Waller-Lab/CompCellScopeAndroid/README.md

# CompCellScopeAndroid
Computational CellScope Android Application from https://journals.plos.org/plosone/article?id=10.1371/journal.pone.0124938
