Waller-Lab/CompCellScopeAndroid/PCB Designs/Eagle/DomeSlice/README - File Descriptions.txt

CompCellScope PCB Design Files
Zack Phillips, UC Berkeley
zkphil@berkeley.edu

Last Modified 2/23/15

The included files are licensed under the BSD Open Source License, as described in the LICENSE.txt file.

These files were created in EAGLE(R) 6.6.0.

This PCB design was used to attach all LEDs to their controllers, facilitating easy soldering by hand. The boards were chained together to provide serial communication across all LEDs. These boards use TLC5926 LED Controller Chips (Texas Instruments) for LED Control. See the Assembly Instructions file for an assembly overview. Our design used 9 identical boards of this design.

--- File List ---
Slice_v1.1.brd   :   EAGLECAD PCB Layout used for controlling the domed LED Array.
Slice_v1.1.sch   :   Schematic for above file
Slice_v1.1.lbr   :   EAGLE Library containing layouts for all parts used in this design
Slice_v1.1.zip   :   Archive of GERBER Files as sent to PCB fabrication house
