Waller-Lab/CompCellScopeAndroid/PCB Designs/Eagle/PowerBoard/README - File Descriptions.txt

CompCellScope Power Board PCB Design Files
Zack Phillips, UC Berkeley
zkphil@berkeley.edu

Last Modified 2/23/15

The included files are licensed under the BSD Open Source License, as described in the LICENSE.txt file.

These files were created in EAGLE(R) 6.6.0.

This PCB design was used to distribute power to each of the 9 LED Controller boards, as well as the arduino. As an input it takes a TDK-Lambda DT150PW120C 120V AC Adaptor, but can accept any 12V power source given slight modification as described in the Assembly Overview file. This device could be improved by adding heatsinks to the 5V regulators, but works as designed for all intended applications.

--- File List ---
MPB_v1.brd    :   EAGLECAD PCB Layout of Power distribution board
MPB_v1.sch    :   Schematic for above file
MPB_v1.lbr    :   EAGLE Library containing layouts for all parts used in this design
MPB_v1.zip    :   Archive of GERBER Files as sent to PCB fabrication house
