Waller-Lab/CompCellScopeAndroid/CAD Designs/MATLAB/channelMap.xlsx

hole | channel
1 | 320
2 | 257
3 | 256
4 | 200
5 | 384
6 | 392
7 | 321
8 | 328
9 | 264
10 | 193
11 | 201
12 | 136
13 | 128
14 | 456
15 | 386
16 | 393
17 | 322
18 | 329
19 | 258
20 | 265
21 | 203
22 | 192
23 | 137
24 | 130
25 | 73
26 | 457
27 | 387
28 | 385
29 | 394
30 | 330
31 | 259
32 | 266
33 | 195
34 | 202
35 | 138
36 | 131
37 | 129
38 | 74
39 | 449
40 | 451
41 | 515
42 | 395
43 | 396
44 | 323
45 | 331
46 | 267
47 | 268
48 | 204
49 | 194
50 | 141
51 | 132
52 | 75
53 | 68
54 | 64
55 | 518
56 | 523
57 | 460
58 | 388
59 | 397
60 | 324
61 | 512
62 | 260
63 | 269
64 | 196
65 | 3
66 | 142
67 | 140
68 | 76
69 | 77
70 | 12
71 | 65
72 | 453
73 | 461
74 | 462
75 | 452
76 | 389
77 | 325
78 | 334
79 | 333
80 | 270
81 | 271
82 | 205
83 | 199
84 | 143
85 | 133
86 | 78
87 | 70
88 | 69
89 | 66
90 | 454
91 | 455
92 | 463
93 | 400
94 | 390
95 | 398
96 | 326
97 | 335
98 | 262
99 | 280
100 | 198
101 | 206
102 | 209
103 | 152
104 | 135
105 | 79
106 | 71
107 | 67
108 | 13
109 | 527
110 | 464
111 | 472
112 | 473
113 | 391
114 | 399
115 | 327
116 | 336
117 | 263
118 | 261
119 | 281
120 | 207
121 | 217
122 | 154
123 | 134
124 | 9
125 | 81
126 | 80
127 | 15
128 | 14
129 | 528
130 | 537
131 | 466
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
