Waller-Lab/CompCellScopeAndroid/Documents/holeMap.png

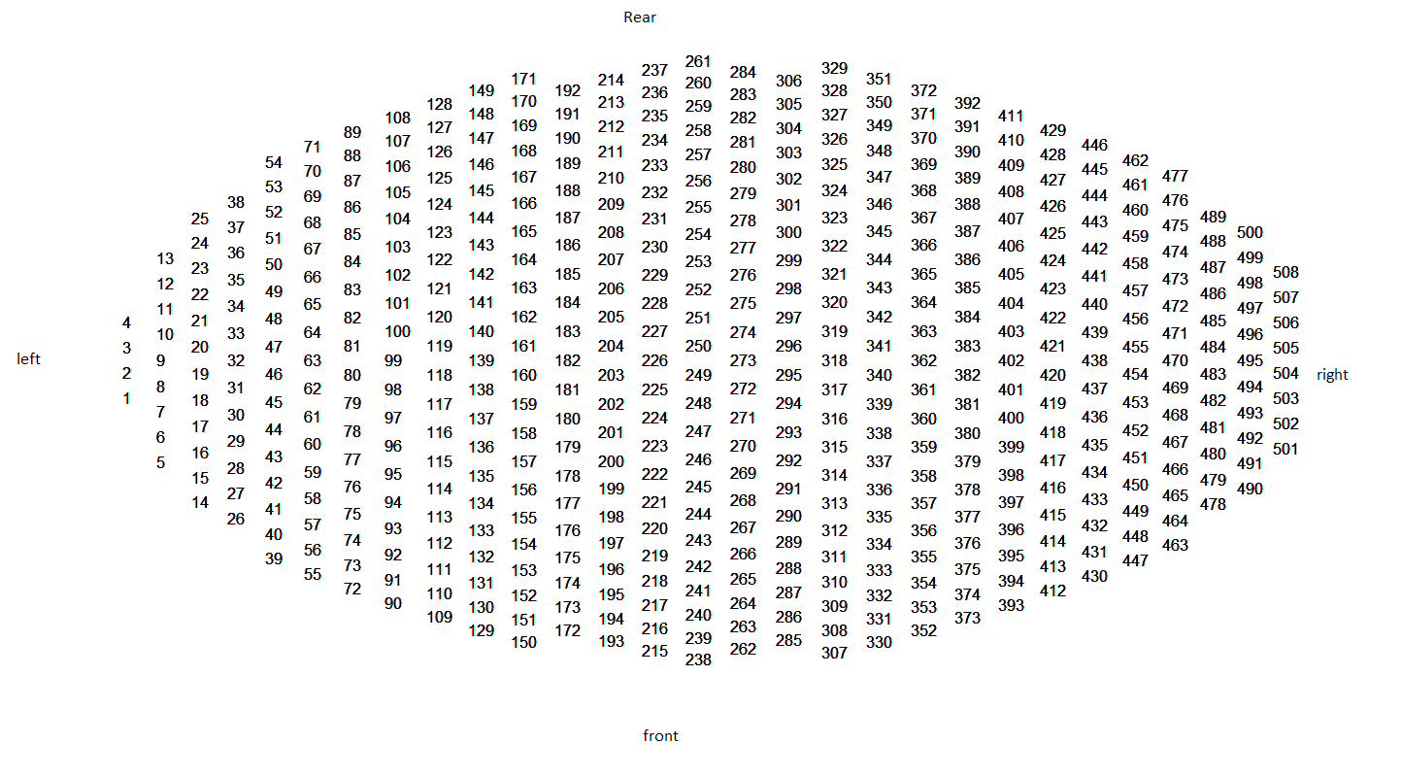
Documents/holeMap.png
