Waller-Lab/CompCellScopeAndroid/Documents/PartsList.ods

Part Name | Quantity Req'd | Supplier | Part Number | Unit Cost | Total Cost | Compiled: | 3/4/2015
TLC5926 LED Driver - TSSOP Package | 36 | Digi-Key | 296-24761-1-ND | $1.39 | $50.04
2.2kΩ Resistors (1%) | 36 | Digi-Key | A105957CT-ND | $0.13 | $4.68
White Light, Thru-Hole LEDs | 508 | Mouser | 593-VAOL-3MWY4 | $0.32 | $162.56
Linear, 3A, 5V Regulator | 8 | Digi-Key | LM1085IT-5.0/NOPB-ND | $5.58 | $44.64
0.1uF Capacitor, Ceramix | 12 | Digi-Key | 399-1097-1-ND | $0.07 | $0.84
Heat Shrink Tubing, 0.5mm ID | 1 | Digi-key | Q2-F3X-1/16-01-MS100FT | $4.62 | $4.62
Kycon Power Connector | 1 | Mouser | 806-KPJX-4S-S | $3.99 | $3.99
12A, 12V Power supply | 1 | Digi-Key | 285-1914-ND | $85.45 | $85.45
Arduino Micro | 1 | Digi-Key | 1050-1066-ND | $24.96 | $24.96
Bluetooth Mate Silver | 1 | Sparkfun | WRL-1257 | $24.95 | $24.95
Female 20 Pos. Recepticle | 1 | Digi-Key | WM2492-ND | $0.90 | $0.90
Female 20 Pos. Connectors. | 40 | Digi-Key | WM1837-ND | $0.11 | $4.40
Male 20 Pos. Plug | 1 | Digi-Key | WM4732-ND | $4.64 | $4.64
SM1 Locking Ring | 1 | ThorLabs | SM1NT | $6.50 | $6.50
4-40x3/8 Socket Head Cap Screw | 2 | McMaster-Carr | 92185A108 | $6.74 | $13.48
4-40x5/16 Button Head Cap Screw | 1 | McMaster-Carr | 98164A430 | $2.87 | $2.87
Threaded Inserts | 2 | McMaster-Carr | 92394A112 | $8.93 | $17.86
Custom Parts | Your prices may vary for these parts:
"Slice" PCB (LED Controller PCB) | 9 | Avanti Circuits, Inc. | - | $39.00 | $351.00
Power Controller Board PCB | 1 | Avanti Circuits, Inc. | - | $112.00 | $112.00
3D Printed Dome, SOMOS 8420 | 1 | InterPRO Models | - | $205.00 | $205.00
3D Printed Stage/Base | 1 | (In House 3D Printer) | - | $30.00 | $30.00
3D Printed Board Holders | 2 | (In House 3D Printer) | - | $10.00 | $20.00
Not included: |  |  |  | GRAND TOTAL: | $1,175.38
Wires | Note - These are absolute quantities, we highly recommend ordering 110-150% of the stated quantities to account for losses during assembly.
Solder
Solder Braid
All Tools
