Waller-Lab/CompCellScopeAndroid/CAD Designs/Inventor/STL Files - Ready to 3D Print/104_CompCellScopeBoardHolder.stl

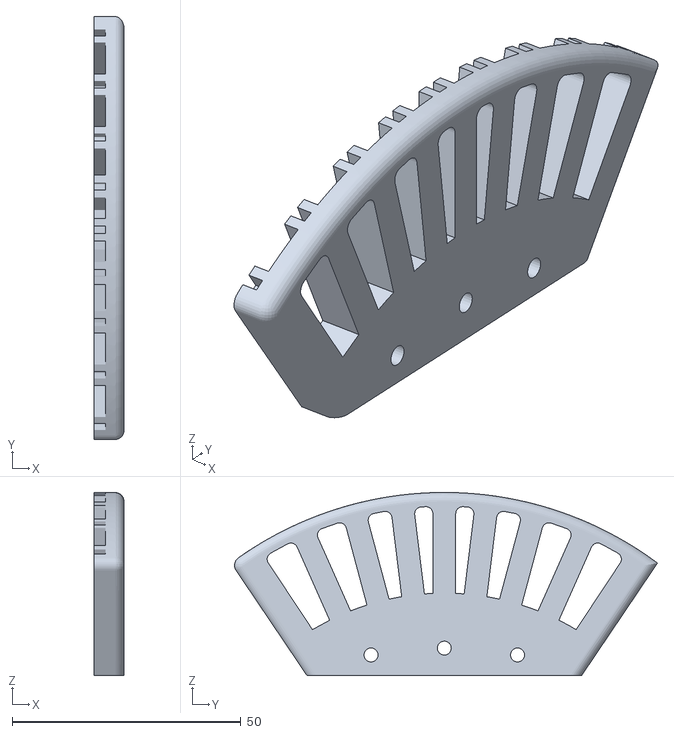
[picture p3: CAD file, 2015-02-24]
CAD Designs/Inventor/STL Files - Ready to 3D Print/104_CompCellScopeBoardHolder.stl
6.60 x 92.4 x 40.0
