Waller-Lab/CompCellScopeAndroid/CAD Designs/Inventor/STL Files - Ready to 3D Print/103_CompCellScopeStage.stl

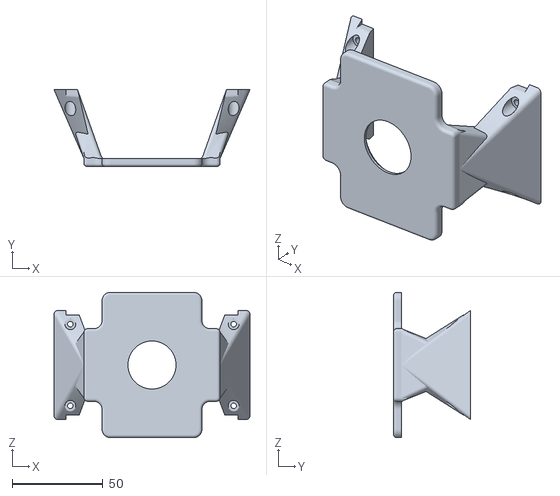
[picture p4: CAD file, 2015-02-24]
CAD Designs/Inventor/STL Files - Ready to 3D Print/103_CompCellScopeStage.stl
108.0 x 42.2 x 80.0
