Waller-Lab/CompCellScopeAndroid/(list of files, cad)

Other CAD files:
CAD Designs/Inventor/101_CompCellScopeAssembly.iam
CAD Designs/Inventor/102_CompCellScopeDome.ipt
CAD Designs/Inventor/103_CompCellScopeStage.ipt
CAD Designs/Inventor/104_CompCellScopeBoardHolder.ipt
CAD Designs/Inventor/901_CompCellScopeBoard_FORPICS.ipt
CAD Designs/Inventor/902_CompCellScopeLED_FORPICS.ipt
