Waller-Lab/CompCellScopeAndroid/Documents/AssemblyOverview.rtf

Android:
- CompCellScope
- CompCellScope Processing
- Binaries
Arduino:
- compCellScope.ino
- MATLAB Script to generate headers
CAD:
- MATLAB script to generate hole pattern
- Inventor Files
PCB:
- Part Library
- EAGLE Design Files
- Gerber files
Documents:
- Parts/Suppliers List
- Installation instructions
- Usage instructions
- Links to cited literature
