Waller-Lab/CompCellScopeAndroid/PCB Designs/Eagle/PowerBoard/MPB_v1.brd

## EAGLE design PCB Designs/Eagle/PowerBoard/MPB_v1.brd (2015-02-24)

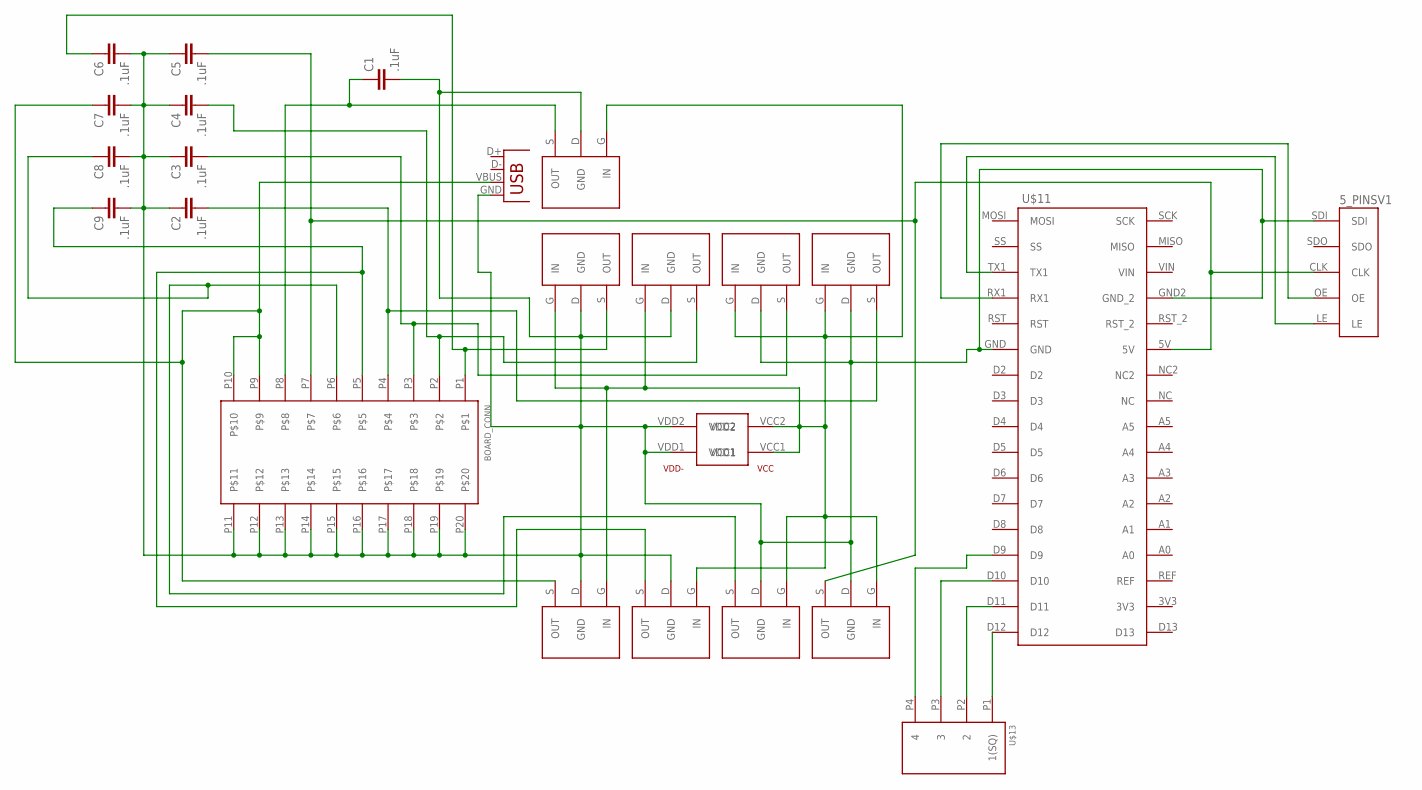
[picture p5: schematic MPB_v1.sch]

Parts:
BOARD_CONN: 20PIN_HEADER; 20PIN_3MMHEADER
C1, C2, C3, C4, C5, C6, C7, C8, C9: .1uF; CAP-PTH-SMALL-KIT
PWR: 4PIN_POWER; KPJX-4S
R1, R2, R3, R4, R5, R6, R7, R8, R9: 5VREG; TO220BH
U$11: ARDUINOMICRO1; ARDUINOMICRO
U$12: 5_PINSV1; 5PIN_HOLES
U$13: 4_PINS1; 4PIN_HOLES
_: USB-A-SMD; USB-A-S-NOSILK-FEMALE

Connections:
unnamed: PWR.VCC1, PWR.VCC2, R1.G (IN), R2.G (IN), R3.G (IN), R4.G (IN), R5.G (IN), R6.G (IN), R7.G (IN), R8.G (IN), R9.G (IN)
unnamed: BOARD_CONN.P1, C6.1, R9.S (OUT)
unnamed: BOARD_CONN.P2, C4.2, R1.S (OUT)
unnamed: U$11.TX1, U$12.LE
unnamed: BOARD_CONN.P3, C3.2, R3.S (OUT)
unnamed: BOARD_CONN.P4, C2.2, R2.S (OUT)
unnamed: BOARD_CONN.P11, BOARD_CONN.P12, BOARD_CONN.P13, BOARD_CONN.P14, BOARD_CONN.P15, BOARD_CONN.P16, BOARD_CONN.P17, BOARD_CONN.P18, BOARD_CONN.P19, BOARD_CONN.P20, C1.2, C2.1, C3.1, C4.1, C5.1, C6.2, C7.2, C8.2, C9.2, PWR.VDD1, PWR.VDD2, R1.D (GND), R2.D (GND), R3.D (GND), R4.D (GND), R5.D (GND), R6.D (GND), R7.D (GND), R8.D (GND), R9.D (GND), U$11.GND, U$11.GND2 (GND_2), U$12.SDI, _.GND
unnamed: BOARD_CONN.P9, BOARD_CONN.P10, C7.1, R5.S (OUT), _.VBUS
unnamed: U$11.D12, U$13.P1 (1(SQ))
unnamed: BOARD_CONN.P5, C9.1, R6.S (OUT)
unnamed: BOARD_CONN.P6, C8.1, R8.S (OUT)
unnamed: BOARD_CONN.P7, C5.2, R4.S (OUT), U$11.5V, U$12.CLK
unnamed: U$11.D11, U$13.P2 (2)
unnamed: U$11.D10, U$13.P3 (3)
unnamed: U$11.D9, U$13.P4 (4)
unnamed: U$11.RX1, U$12.OE
unnamed: BOARD_CONN.P8, C1.1, R7.S (OUT)

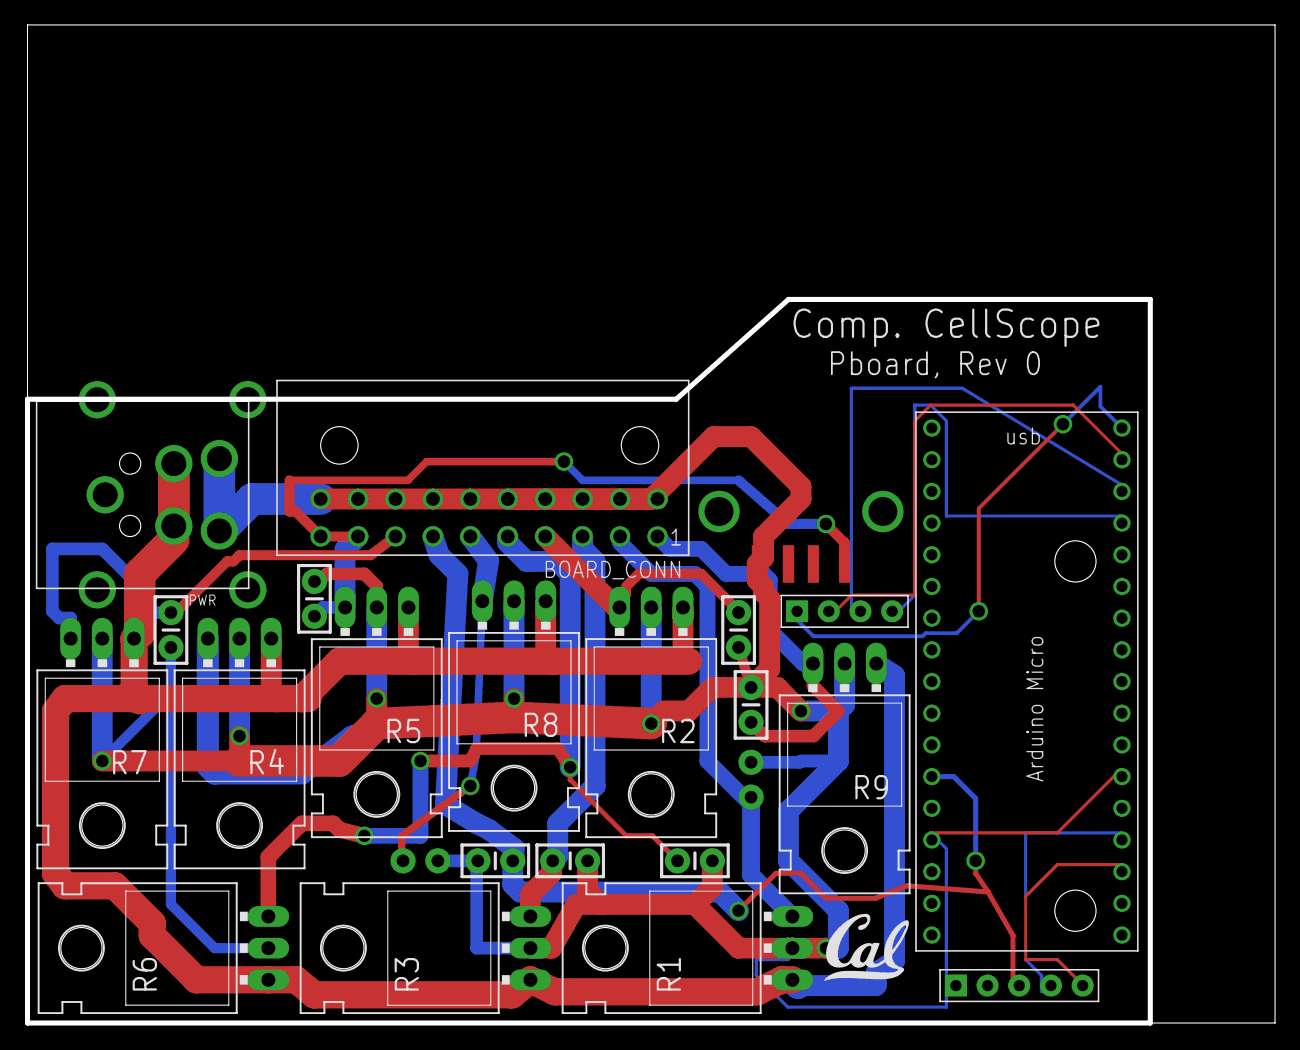
[picture p6: board MPB_v1.brd from above]

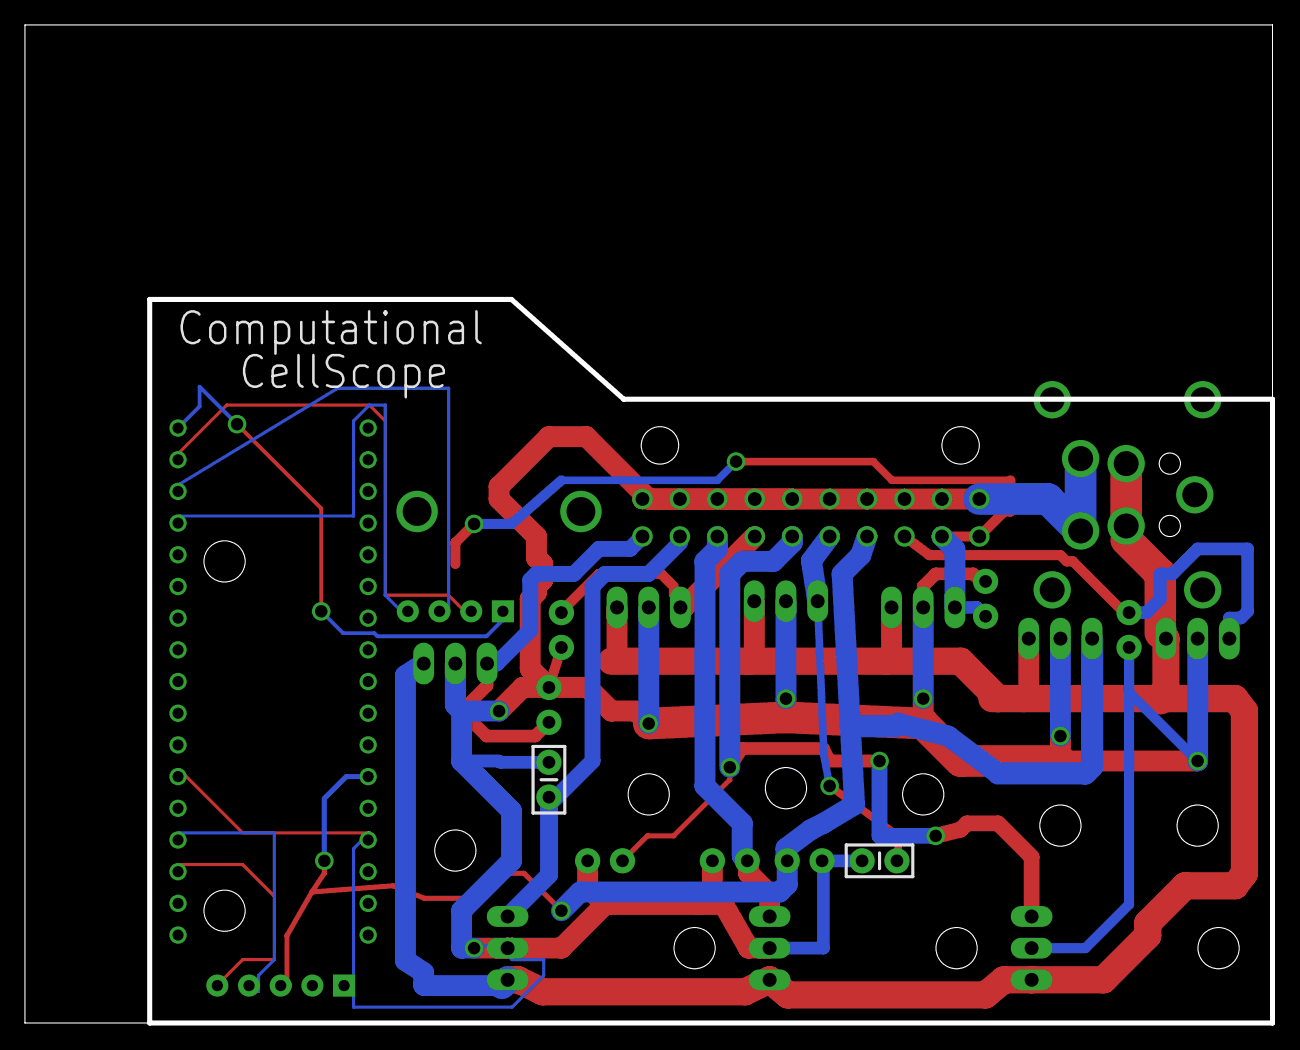
[picture p7: board MPB_v1.brd from below]

Board: 2 copper layers, 100.0 x 80.0 mm, 24 parts (2 on the bottom side), 17 nets.
