Waller-Lab/CompCellScopeAndroid/PCB Designs/Eagle/DomeSlice/Slice_v1.1.brd

## EAGLE design PCB Designs/Eagle/DomeSlice/Slice_v1.1.brd (2015-02-24)

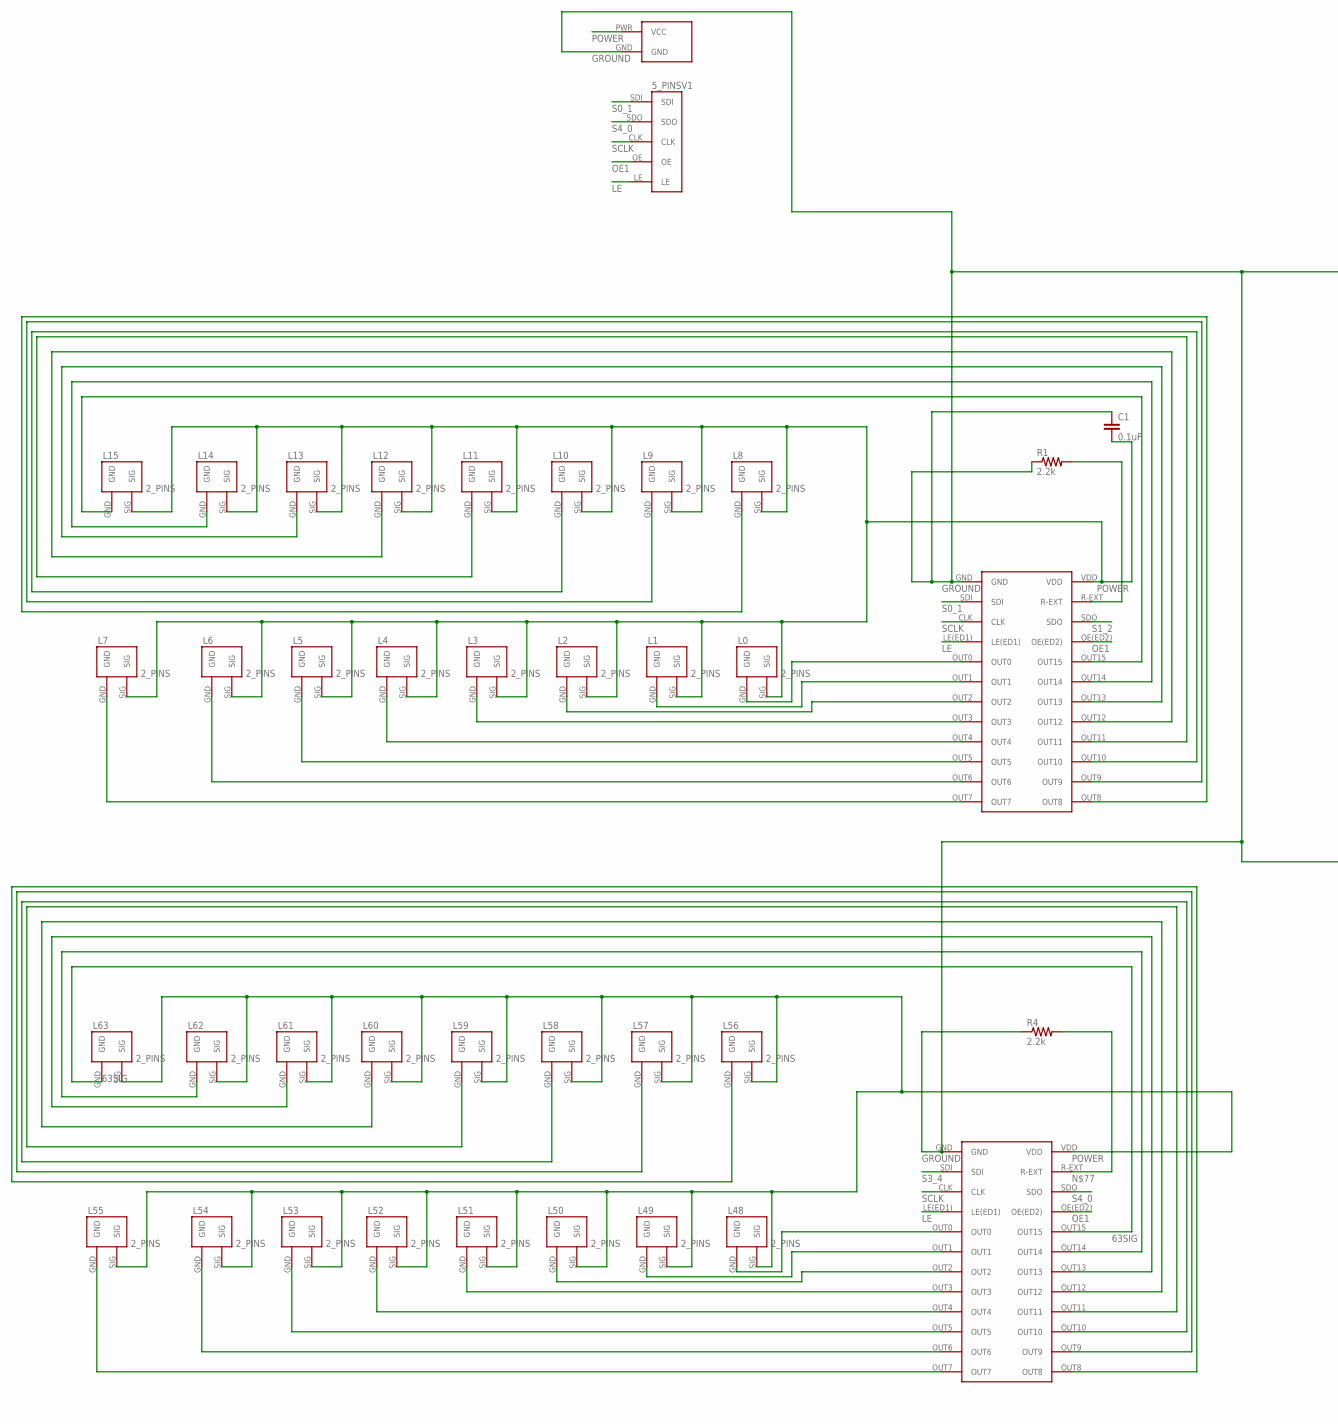
[picture p8: schematic Slice_v1.1.sch, part in row 1, column 1]

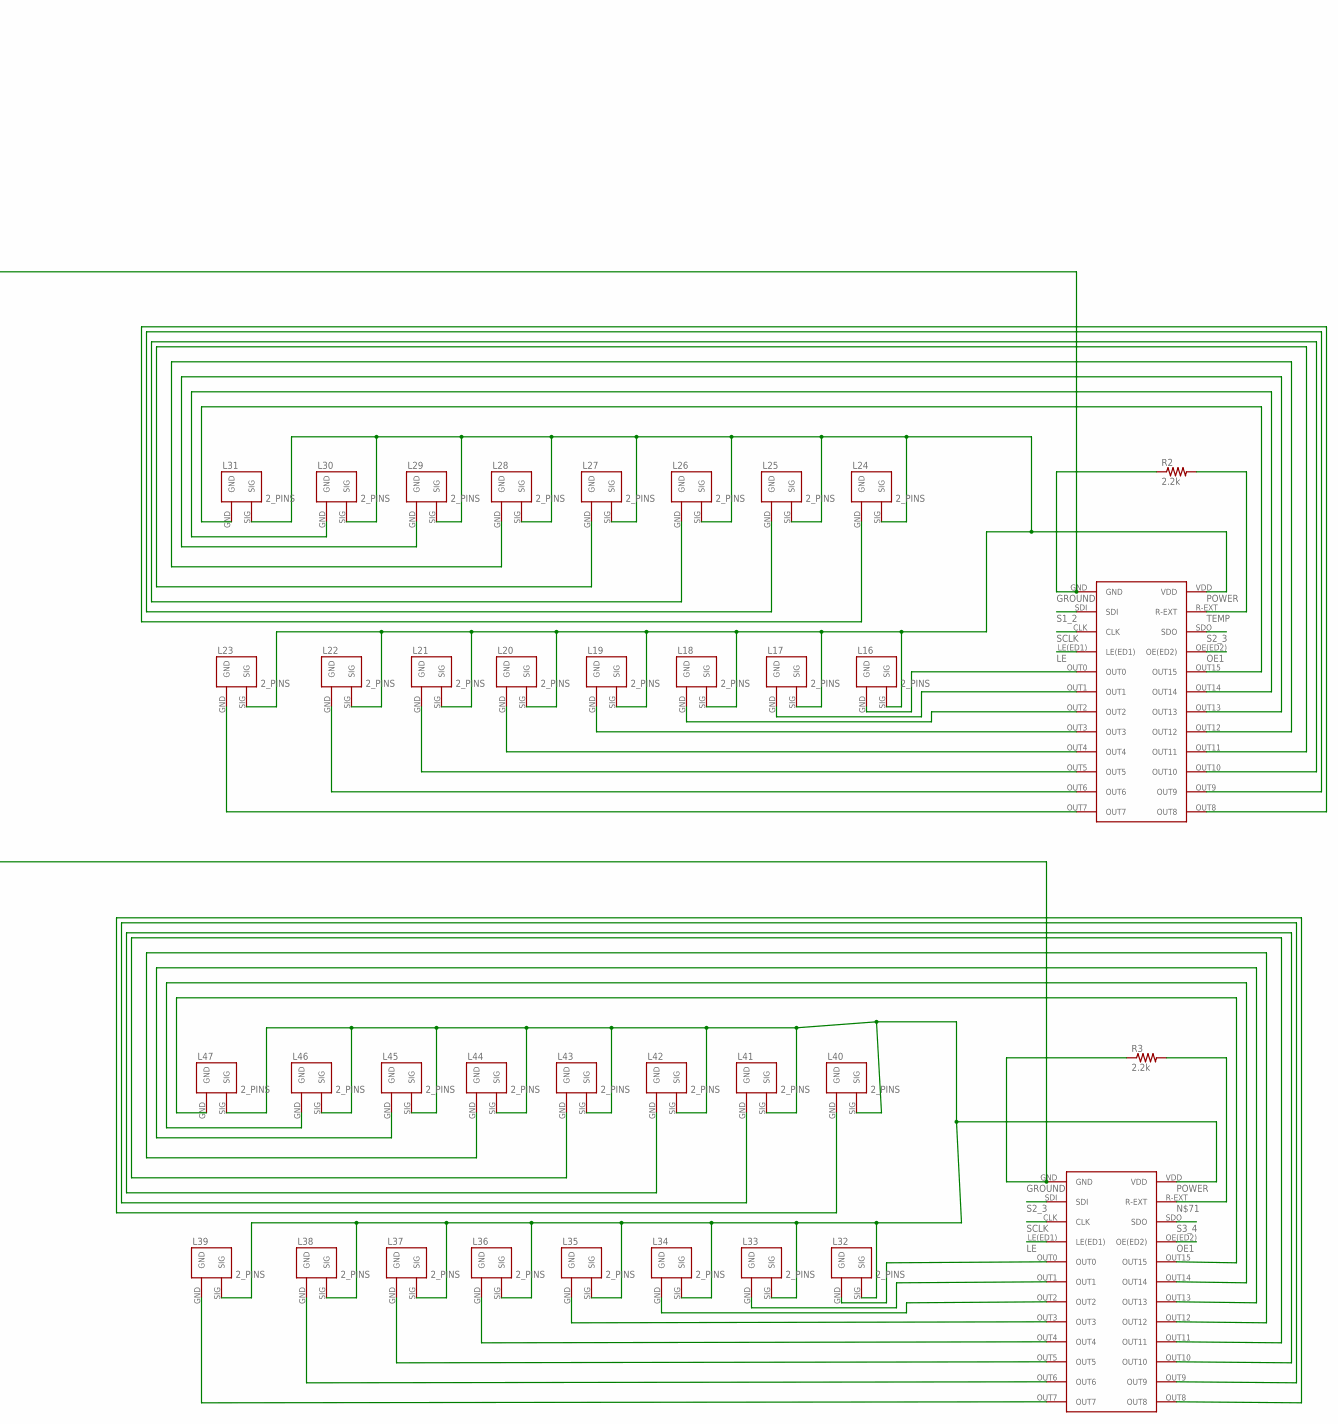
[picture p9: schematic Slice_v1.1.sch, part in row 1, column 2]

Parts:
C1: 0.1uF; 0603-CAP
L0, L1, L2, L3, L4, L5, L6, L7, L8, L9, L10, L11, L12, L13, L14, L15, L16, L17, L18, L19, L20, L21, L22, L23, L24, L25, L26, L27, L28, L29, L30, L31, L32, L33, L34, L35, L36, L37, L38, L39, L40, L41, L42, L43, L44, L45, L46, L47, L48, L49, L50, L51, L52, L53, L54, L55, L56, L57, L58, L59, L60, L61, L62, L63: 2_PINS; 2PIN_HOLES
R1, R2, R3, R4: 2.2k; AXIAL-0.3EZ
U$1, U$2, U$3, U$4: TLC5926
U$6: 2PIN_2ATE; TE_A32471
U$7: 5_PINSV1; 5PIN_HOLES

Connections:
63SIG: L63.GND, U$2.OUT15
GROUND: C1.1, R1.P$1 (1), R2.P$1 (1), R3.P$1 (1), R4.P$1 (1), U$1.GND, U$2.GND, U$3.GND, U$4.GND, U$6.GND
GSCL: L31.GND, U$4.OUT15
LE: U$1.LE(ED1), U$2.LE(ED1), U$3.LE(ED1), U$4.LE(ED1), U$7.LE
unnamed: L7.GND, U$1.OUT7
unnamed: L6.GND, U$1.OUT6
unnamed: L5.GND, U$1.OUT5
unnamed: L4.GND, U$1.OUT4
unnamed: L3.GND, U$1.OUT3
unnamed: L2.GND, U$1.OUT2
unnamed: L1.GND, U$1.OUT1
unnamed: L0.GND, U$1.OUT0
unnamed: L15.GND, U$1.OUT15
unnamed: L14.GND, U$1.OUT14
unnamed: L13.GND, U$1.OUT13
unnamed: L12.GND, U$1.OUT12
unnamed: L11.GND, U$1.OUT11
unnamed: L10.GND, U$1.OUT10
unnamed: L9.GND, U$1.OUT9
unnamed: L8.GND, U$1.OUT8
unnamed: L23.GND, U$4.OUT7
unnamed: L22.GND, U$4.OUT6
unnamed: L21.GND, U$4.OUT5
unnamed: L20.GND, U$4.OUT4
unnamed: L19.GND, U$4.OUT3
unnamed: L18.GND, U$4.OUT2
unnamed: L17.GND, U$4.OUT1
unnamed: L16.GND, U$4.OUT0
unnamed: L30.GND, U$4.OUT14
unnamed: L29.GND, U$4.OUT13
unnamed: L28.GND, U$4.OUT12
unnamed: L27.GND, U$4.OUT11
unnamed: L26.GND, U$4.OUT10
unnamed: L25.GND, U$4.OUT9
unnamed: L24.GND, U$4.OUT8
unnamed: L55.GND, U$2.OUT7
unnamed: L54.GND, U$2.OUT6
unnamed: L53.GND, U$2.OUT5
unnamed: L52.GND, U$2.OUT4
unnamed: L51.GND, U$2.OUT3
unnamed: L50.GND, U$2.OUT2
unnamed: L49.GND, U$2.OUT1
unnamed: L48.GND, U$2.OUT0
unnamed: L62.GND, U$2.OUT14
unnamed: L61.GND, U$2.OUT13
unnamed: L60.GND, U$2.OUT12
unnamed: L59.GND, U$2.OUT11
unnamed: L58.GND, U$2.OUT10
unnamed: L57.GND, U$2.OUT9
unnamed: L56.GND, U$2.OUT8
unnamed: L39.GND, U$3.OUT7
unnamed: L38.GND, U$3.OUT6
unnamed: L37.GND, U$3.OUT5
unnamed: L36.GND, U$3.OUT4
unnamed: L35.GND, U$3.OUT3
unnamed: L34.GND, U$3.OUT2
unnamed: L33.GND, U$3.OUT1
unnamed: L32.GND, U$3.OUT0
unnamed: L46.GND, U$3.OUT14
unnamed: L45.GND, U$3.OUT13
unnamed: L44.GND, U$3.OUT12
unnamed: L43.GND, U$3.OUT11
unnamed: L42.GND, U$3.OUT10
unnamed: L41.GND, U$3.OUT9
unnamed: L40.GND, U$3.OUT8
unnamed: R1.P$2 (2), U$1.R-EXT
unnamed: R3.P$2 (2), U$3.R-EXT
unnamed: R4.P$2 (2), U$2.R-EXT
OE1: U$1.OE(ED2), U$2.OE(ED2), U$3.OE(ED2), U$4.OE(ED2), U$7.OE
POWER: C1.2, L0.SIG, L1.SIG, L2.SIG, L3.SIG, L4.SIG, L5.SIG, L6.SIG, L7.SIG, L8.SIG, L9.SIG, L10.SIG, L11.SIG, L12.SIG, L13.SIG, L14.SIG, L15.SIG, L16.SIG, L17.SIG, L18.SIG, L19.SIG, L20.SIG, L21.SIG, L22.SIG, L23.SIG, L24.SIG, L25.SIG, L26.SIG, L27.SIG, L28.SIG, L29.SIG, L30.SIG, L31.SIG, L32.SIG, L33.SIG, L34.SIG, L35.SIG, L36.SIG, L37.SIG, L38.SIG, L39.SIG, L40.SIG, L41.SIG, L42.SIG, L43.SIG, L44.SIG, L45.SIG, L46.SIG, L47.SIG, L48.SIG, L49.SIG, L50.SIG, L51.SIG, L52.SIG, L53.SIG, L54.SIG, L55.SIG, L56.SIG, L57.SIG, L58.SIG, L59.SIG, L60.SIG, L61.SIG, L62.SIG, L63.SIG, U$1.VDD, U$2.VDD, U$3.VDD, U$4.VDD, U$6.PWR (VCC)
S0_1: U$1.SDI, U$7.SDI
S1_2: U$1.SDO, U$4.SDI
S2_3: U$3.SDI, U$4.SDO
S3_4: U$2.SDI, U$3.SDO
S4_0: U$2.SDO, U$7.SDO
SCLK: U$1.CLK, U$2.CLK, U$3.CLK, U$4.CLK, U$7.CLK
SOUT: L47.GND, U$3.OUT15
TEMP: R2.P$2 (2), U$4.R-EXT

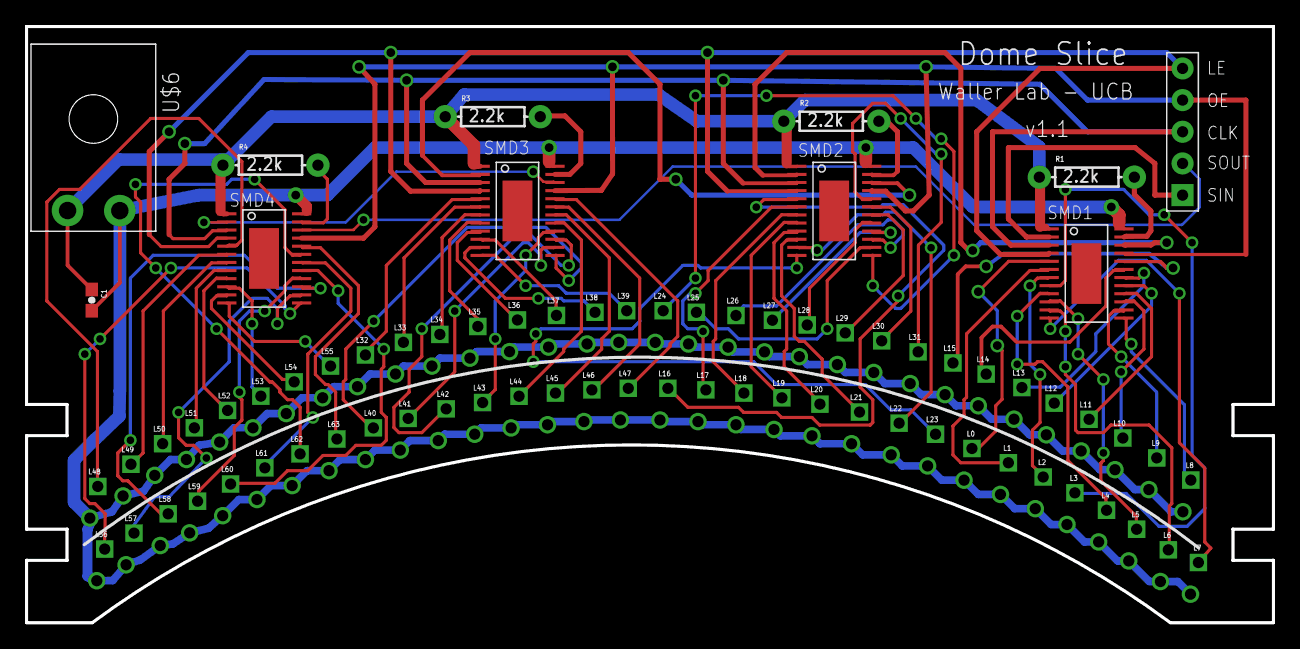
[picture p10: board Slice_v1.1.brd from above]

Board: 2 copper layers, 100.0 x 47.8 mm, 75 parts (0 on the bottom side), 78 nets.
