Waller-Lab/CompCellScopeAndroid/Arduino/compCellScopeReciever_v4/arrayCoordinates.h

// FORMAT: hole number,, channel, 1000*Phi, 1000*Theta, 1000*angle to z-axis
PROGMEM const int ledMap[508][5] = {
/*  1*/ {1, 320, -113, -726, 673}, 
/*  2*/ {2, 257, -38, -726, 665}, 
/*  3*/ {3, 256, 38, -726, 665}, 
/*  4*/ {4, 200, 113, -726, 673}, 
/*  5*/ {5, 384, -298, -676, 691}, 
/*  6*/ {6, 392, -223, -676, 664}, 
/*  7*/ {7, 321, -149, -676, 643}, 
/*  8*/ {8, 328, -74, -676, 630}, 
/*  9*/ {9, 264, 0, -676, 626}, 
/* 10*/ {10, 193, 74, -676, 630}, 
/* 11*/ {11, 201, 149, -676, 643}, 
/* 12*/ {12, 136, 223, -676, 664}, 
/* 13*/ {13, 128, 298, -676, 691}, 
/* 14*/ {14, 456, -405, -626, 706}, 
/* 15*/ {15, 386, -331, -626, 670}, 
/* 16*/ {16, 393, -258, -626, 639}, 
/* 17*/ {17, 322, -184, -626, 614}, 
/* 18*/ {18, 329, -110, -626, 596}, 
/* 19*/ {19, 258, -37, -626, 587}, 
/* 20*/ {20, 265, 37, -626, 587}, 
/* 21*/ {21, 203, 110, -626, 596}, 
/* 22*/ {22, 192, 184, -626, 614}, 
/* 23*/ {23, 137, 258, -626, 639}, 
/* 24*/ {24, 130, 331, -626, 670}, 
/* 25*/ {25, 73, 405, -626, 706}, 
/* 26*/ {26, 457, -437, -576, 690}, 
/* 27*/ {27, 387, -364, -576, 651}, 
/* 28*/ {28, 385, -291, -576, 616}, 
/* 29*/ {29, 394, -218, -576, 586}, 
/* 30*/ {30, 330, -146, -576, 564}, 
/* 31*/ {31, 259, -73, -576, 549}, 
/* 32*/ {32, 266, 0, -576, 545}, 
/* 33*/ {33, 195, 73, -576, 549}, 
/* 34*/ {34, 202, 146, -576, 564}, 
/* 35*/ {35, 138, 218, -576, 586}, 
/* 36*/ {36, 131, 291, -576, 616}, 
/* 37*/ {37, 129, 364, -576, 651}, 
/* 38*/ {38, 74, 437, -576, 690}, 
/* 39*/ {39, 449, -540, -526, 718}, 
/* 40*/ {40, 451, -468, -526, 675}, 
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
};
