Waller-Lab/CompCellScopeAndroid/Arduino/compCellScopeReciever_v4/dpcmaps_bit.h

//pattern_bitmaps.h
//Generated 23-Feb-2015

// List of valid NAs in this file:
PROGMEM const double validNA[11] = {0.1, 0.15, 0.2, 0.25, 0.3, 0.35, 0.4, 0.45, 0.5, 0.55, 0.6};

// This list of LED numbers was generated from berkeley.bmp
PROGMEM const int calLogoHoles[152] = {59,60,61,62,63,64,72,76,77,78,79,80,81,82,83,84,90,91,94,95,96,97,98,99,100,101,102,103,104,110,111,113,114,121,122,123,124,131,132,134,144,145,146,152,153,156,167,168,174,175,178,179,180,190,191,195,196,198,199,200,201,202,203,212,213,217,218,219,221,222,225,226,232,236,241,242,245,250,256,259,264,265,266,268,269,270,271,274,281,282,287,288,290,291,293,294,295,296,309,310,311,313,319,332,333,337,353,354,358,359,360,361,362,363,364,374,375,377,378,379,380,381,382,383,384,385,386,394,395,396,397,402,405,406,407,413,414,415,422,426,427,432,441,442,445,446,460,461,462};

// FORMAT: top, bottom, left, right, bf, darkfield, annulus, alignment
PROGMEM const int naHoles10[36][8] = {
   {0, 0, 0, 0, 0, 64508, 256, 0}, 
   {0, 0, 0, 0, 0, 55807, 0, 0}, 
   {0, 0, 0, 0, 0, 65526, 0, 0}, 
   {0, 0, 0, 0, 0, 63071, 4, 0}, 
   {0, 0, 0, 0, 0, 65279, 0, 0}, 
   {0, 0, 0, 0, 0, 62207, 0, 0}, 
   {0, 0, 0, 0, 0, 65535, 0, 0}, 
   {0, 0, 0, 0, 0, 65436, 0, 0}, 
   {0, 0, 0, 0, 0, 63487, 0, 0}, 
   {0, 0, 0, 0, 0, 57343, 32928, 0}, 
   {0, 0, 0, 0, 0, 65535, 1551, 0}, 
   {0, 0, 0, 0, 0, 65535, 0, 0}, 
   {0, 0, 0, 0, 0, 65503, 0, 0}, 
   {128, 0, 0, 128, 128, 16255, 13433, 0}, 
   {0, 1, 0, 1, 1, 61680, 45232, 8}, 
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
   {0, 65534, 65534, 0, 65534, 0, 0, 0}, 
   {31486, 1281, 32767, 0, 32767, 0, 0, 0}, 
   {7, 0, 7, 0, 7, 2944, 2944, 8}, 
   {0, 3, 3, 0, 3, 32832, 32832, 0}, 
   {0, 0, 6144, 0, 6144, 17, 17, 0}, 
   {15, 0, 15, 0, 15, 0, 0, 0}, 
   {1016, 1024, 1112, 928, 2040, 0, 0, 0} 
};
