Waller-Lab/CompCellScopeAndroid/(commit log)

2015-02-24 Added latest PCB Designs, CAD, and Arduino code
    [101_CompCellScopeAssembly.iam, 102_CompCellScopeDome.ipt, 103_CompCellScopeStage.ipt, 103_CompCellScopeStage.stl, 104_CompCellScopeBoardHolder.ipt, 104_CompCellScopeBoardHolder.stl, 901_CompCellScopeBoard_FORPICS.ipt, 902_CompCellScopeLED_FORPICS.ipt]
2015-03-04 Added Parts List
    [PartsList.ods]
